hbqtechnologycompany/HBQ-Artix-7-Motion-Control/HBQ_PCIe_BaseCard_V2 Block diagram.jpg

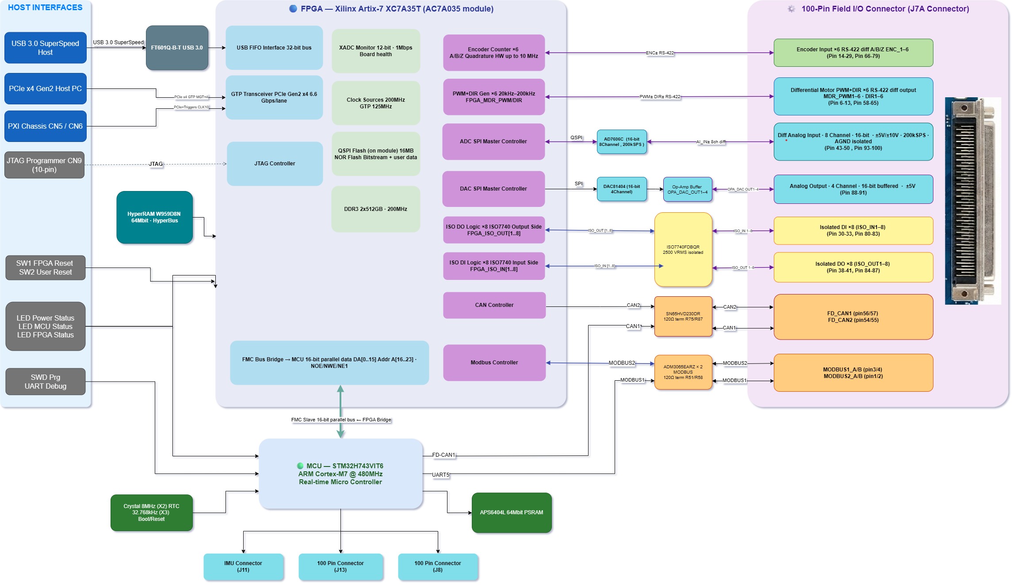
HBQ_PCIe_BaseCard_V2 Block diagram.jpg
