hbqtechnologycompany/HBQ-Artix-7-Motion-Control/Power Scheme 2.jpg

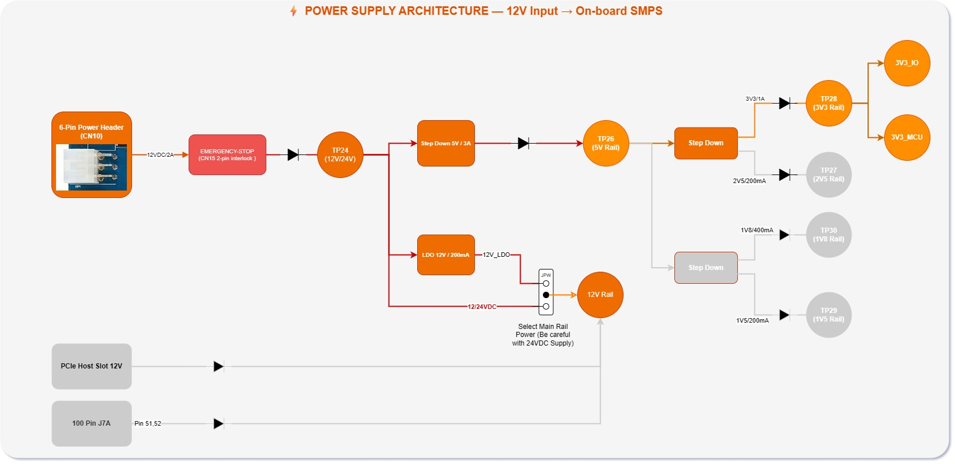
Power Scheme 2.jpg
