hbqtechnologycompany/HBQ-Artix-7-Motion-Control/Power Scheme Full.jpg

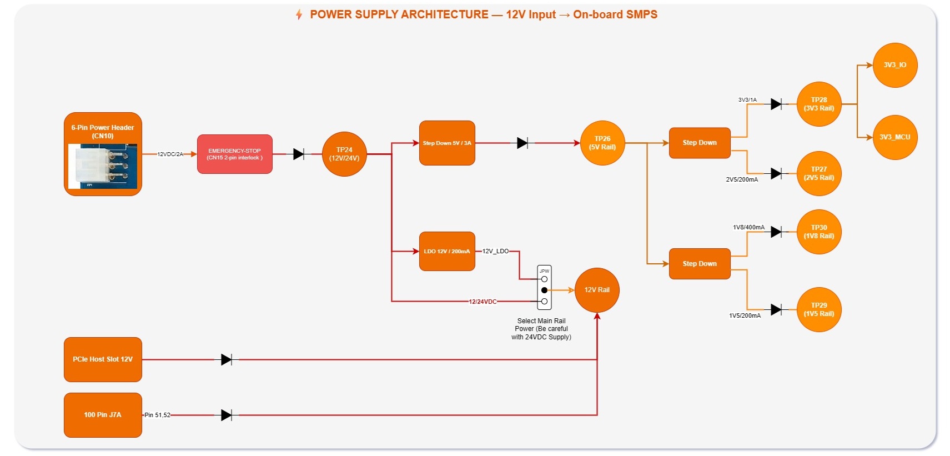
Power Scheme Full.jpg
