hbqtechnologycompany/HBQ-Artix-7-Motion-Control/(commit log)

2026-04-13 Remove PCB image from README
    Removed PCB image from the README file.
2026-04-14 update chuẩn hóa tài liệu
